volab/CNC_VoLAB/Readme.rst

++++++++++++++++++++++++++++++++++++++++++++++++++++++++++++++++++++++++++++
CNC Volab
++++++++++++++++++++++++++++++++++++++++++++++++++++++++++++++++++++++++++++

:Auteurs:              Gilles et Joël Le VoLab
:Site_Web:             http://www.vorobotics.com/
:Projet:               CNCN Volab.
:Version:              2022
:documentation:        https://volab.github.io/CNC_VoLAB/
:Licence:              CC0 4.0
:Liens:                https://creativecommons.org/licenses

Dépôt distant de notre CNC

Construite à partir d'une ancienne Charly Robot.
