volab/CNC_VoLAB/06-userDoc/documentation/materiaux.rst

++++++++++++++++++++++++++++++++++++++++++++++++++++++++++++++++++++++++++++++++++++++++++++++++++++
Matériaux
++++++++++++++++++++++++++++++++++++++++++++++++++++++++++++++++++++++++++++++++++++++++++++++++++++

:Auteur: J.Soranzo
:Date de création: 05/2022
:Date dernière maj: 05/2022
:Societe: VoRoBoTics
:Entity: VoLAB

====================================================================================================
ABS bi-couche
====================================================================================================

`GRAVIERBEDARF.de`_

.. _`GRAVIERBEDARF.de` : https://www.gravierbedarf.de/epages/63201300.sf/fr_FR/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

====================================================================================================
Weblinks
====================================================================================================

.. target-notes::
