volab/CNC_VoLAB/08-rushs/04-pictures/IMG_20201017_180309.jpg

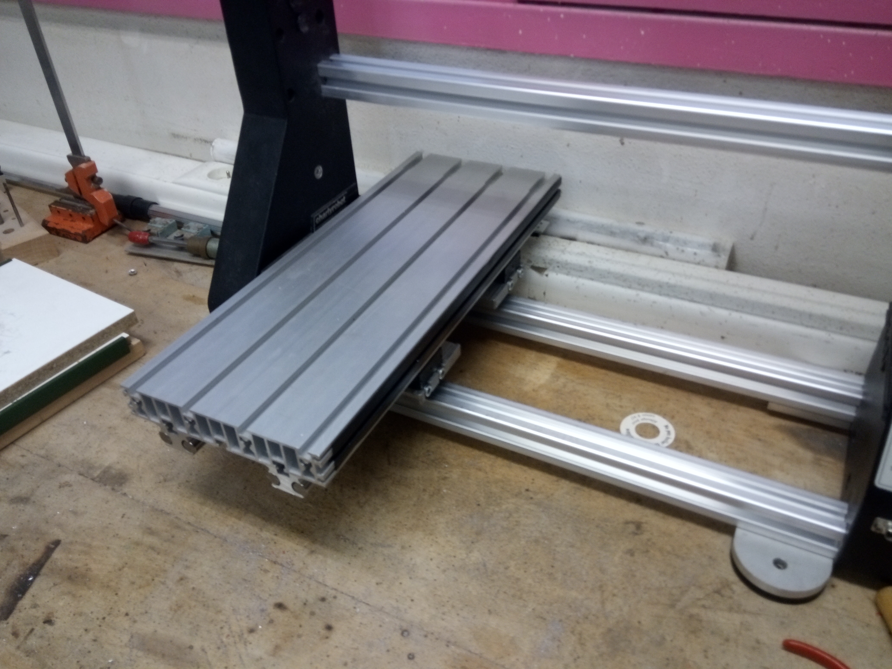
08-rushs/04-pictures/IMG_20201017_180309.jpg
