volab/CNC_VoLAB/08-rushs/04-pictures/IMG_20210306_161401.jpg

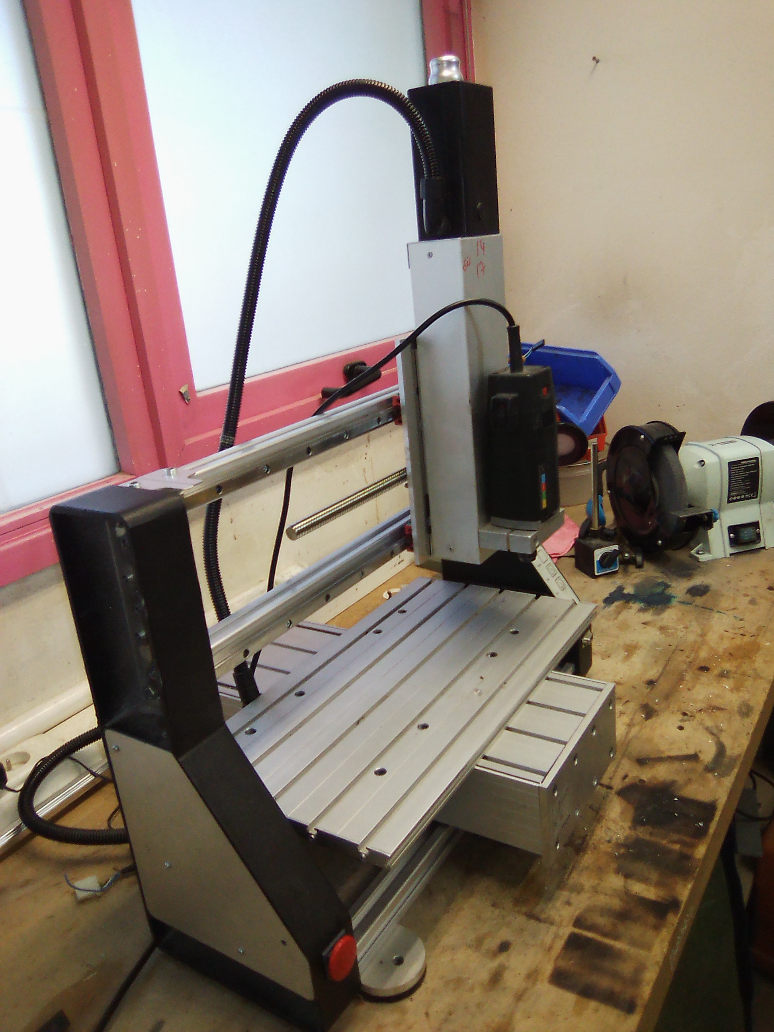
08-rushs/04-pictures/IMG_20210306_161401.jpg
