volab/CNC_VoLAB/08-rushs/04-pictures/IMG_20210313_164209.jpg

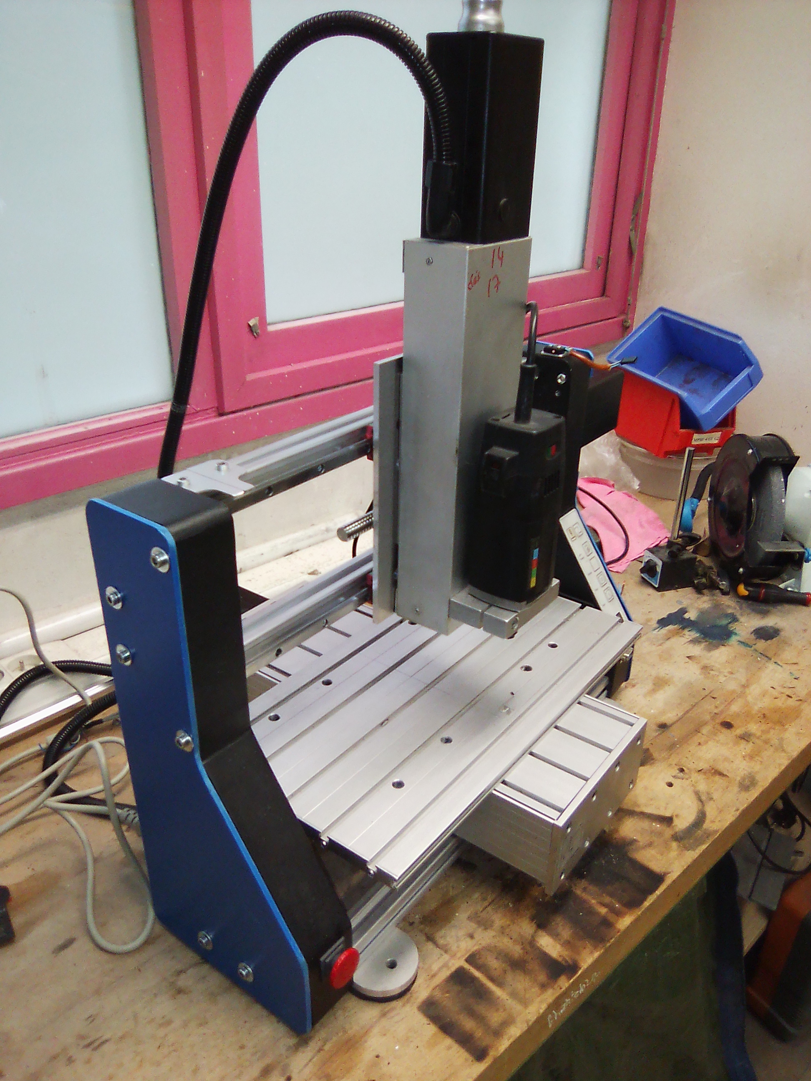
08-rushs/04-pictures/IMG_20210313_164209.jpg
