volab/CNC_VoLAB/08-rushs/04-pictures/IMG_20210320_154829.jpg

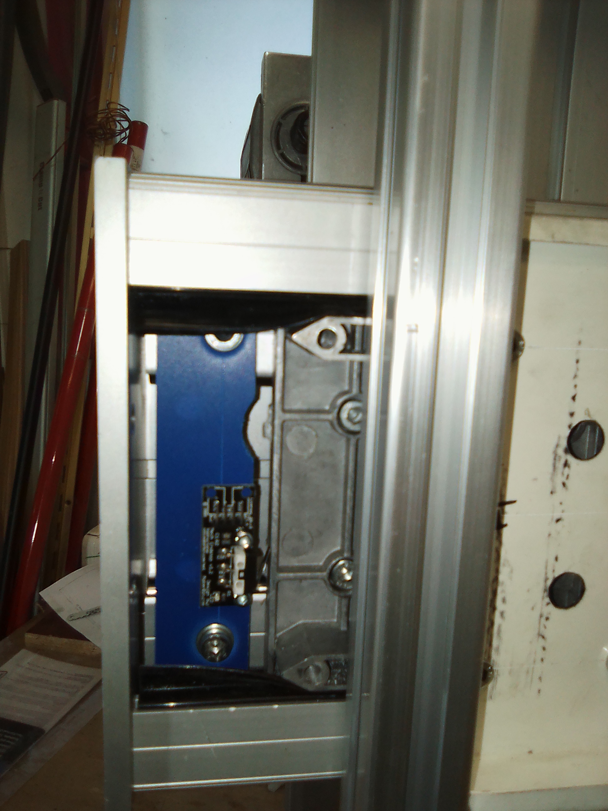
08-rushs/04-pictures/IMG_20210320_154829.jpg
