volab/CNC_VoLAB/08-rushs/04-pictures/IMG_20210320_164424.jpg

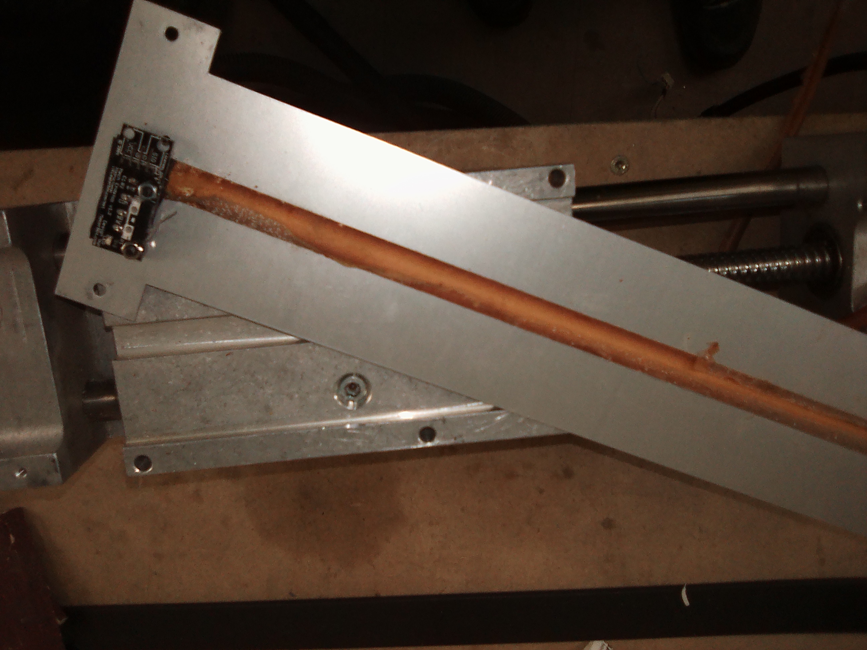
08-rushs/04-pictures/IMG_20210320_164424.jpg
