volab/CNC_VoLAB/08-rushs/04-pictures/IMG_20210424_140324.jpg

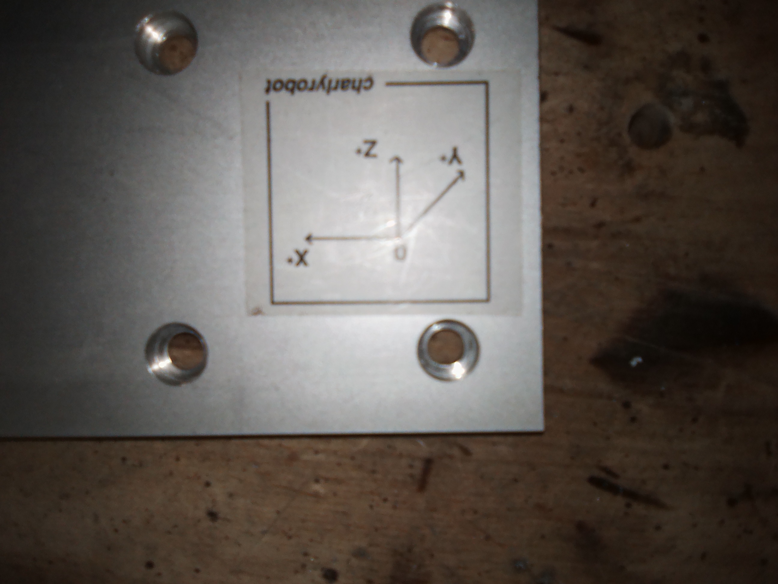
08-rushs/04-pictures/IMG_20210424_140324.jpg
