volab/CNC_VoLAB/08-rushs/04-pictures/IMG_20210501_161735.jpg

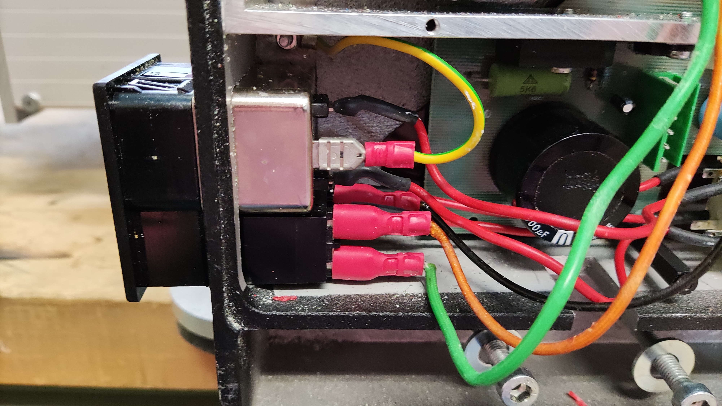
08-rushs/04-pictures/IMG_20210501_161735.jpg
