volab/CNC_VoLAB/08-rushs/04-pictures/IMG_20211218_153628.jpg

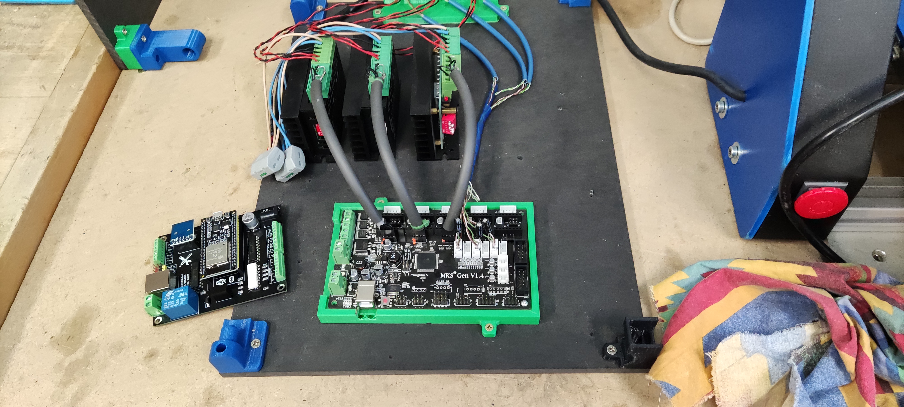
08-rushs/04-pictures/IMG_20211218_153628.jpg
