volab/CNC_VoLAB/08-rushs/04-pictures/IMG_20220129_194602.jpg

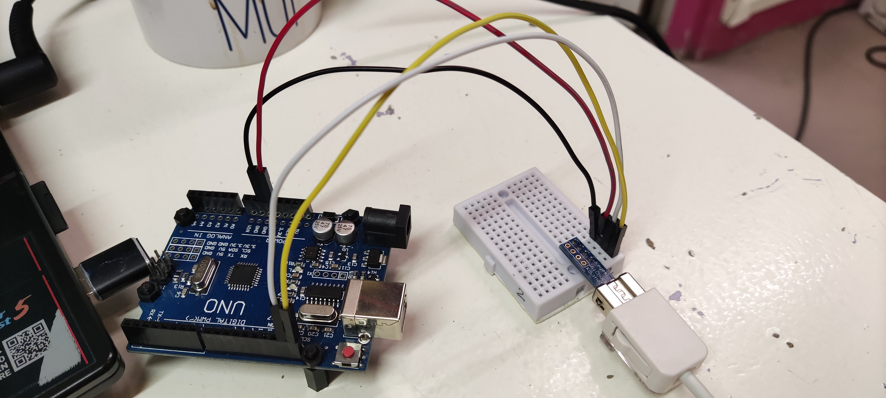
08-rushs/04-pictures/IMG_20220129_194602.jpg
