volab/CNC_VoLAB/08-rushs/04-pictures/IMG_20220527_151818.jpg

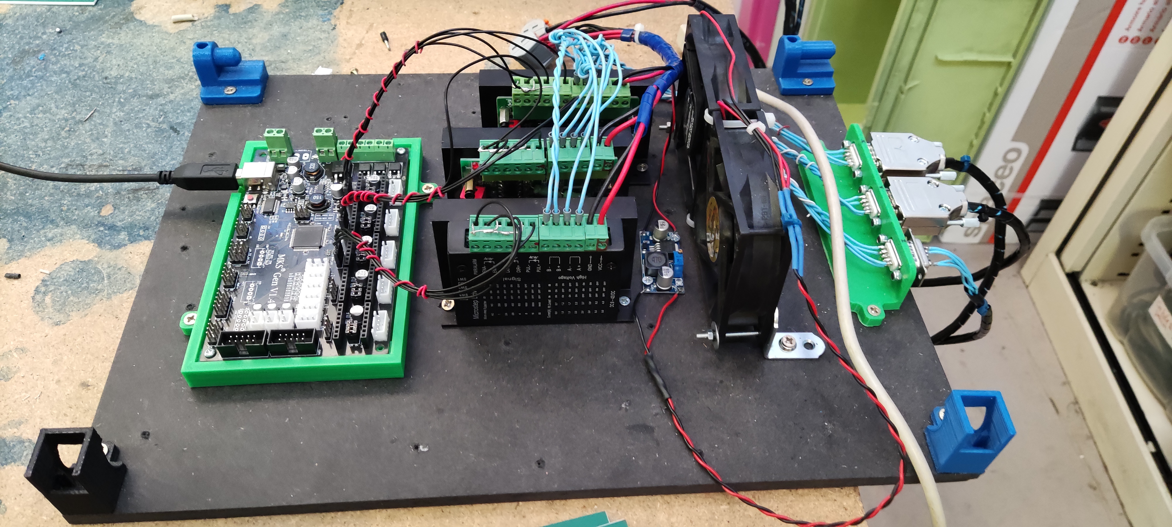
08-rushs/04-pictures/IMG_20220527_151818.jpg
