volab/CNC_VoLAB/08-rushs/04-pictures/resize/triede300.jpg

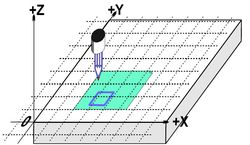
08-rushs/04-pictures/resize/triede300.jpg
