volab/CNC_VoLAB/08-rushs/04-pictures/triede.gif

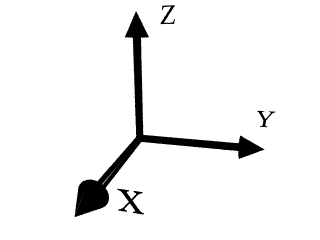
08-rushs/04-pictures/triede.gif
