volab/CNC_VoLAB/08-rushs/04-pictures/triede.jpg

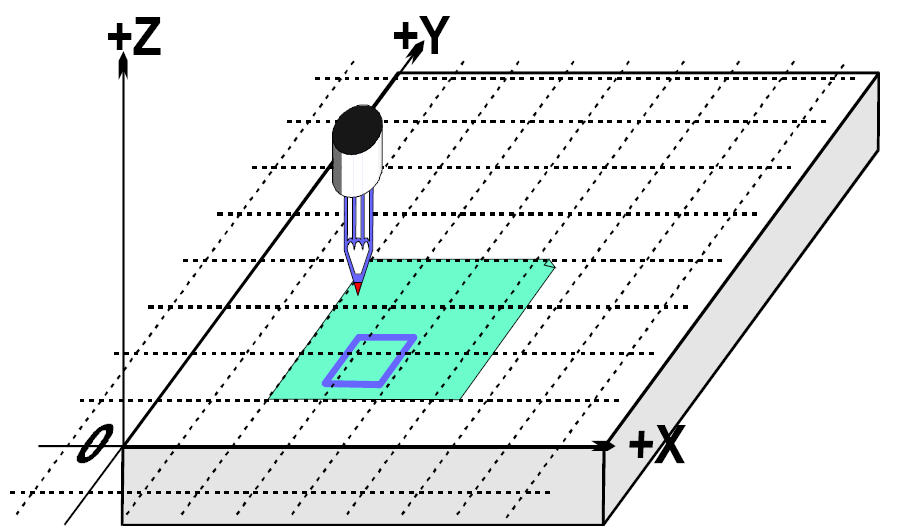
08-rushs/04-pictures/triede.jpg
