volab/CNC_VoLAB/03-conception/2020/designMeca/assemblageFreecad/CNC_VOLAB_2020_exportFromFusion360_220917_1454.FCStd

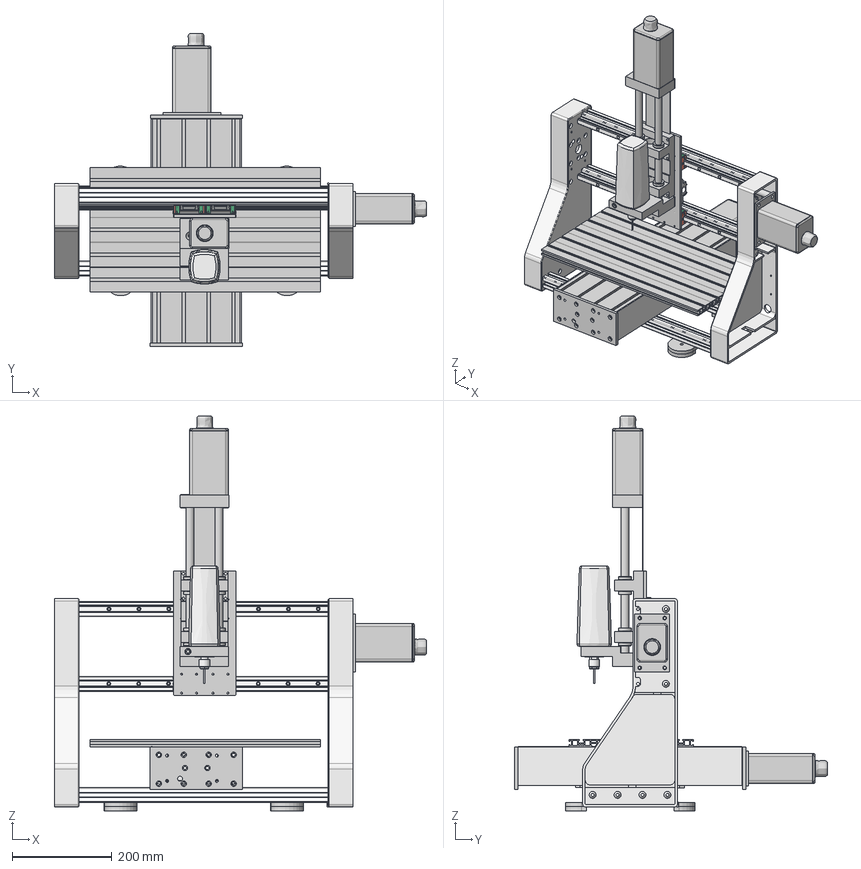
[picture p45: CAD file, 2022-11-12]
03-conception/2020/designMeca/assemblageFreecad/CNC_VOLAB_2020_exportFromFusion360_220917_1454.FCStd
747.7 x 628.2 x 793.0 mm
pied_caoutchouc v1
30X30 - T-slot - Aluminium Profile v1
pied_caoutchouc v002
pied_caoutchouc v003
30X30 - T-slot - Aluminium Profile v002
pied_caoutchouc v004
flasque_gauche v4
flasque_charioTable v1
rail_charioTable v1
rail_charioTable v002
roulement_lineaire v1
roulement_lineaire v002
Composant1
roulement_lineaire v003
roulement_lineaire v004
flasque_charioTable_moteur v1
charioTable
plaqueSupportMoteur v1
moteurMS110 v1
moteurEnveloppe v1
couvercle v1
bouton v1
plaqueTable v1
flasque_protection_chariotTable v1
flasque_protection_chariotTable v002
roulement_lineaire v005
roulement_lineaire v006
Composant002
roulement_lineaire v007
roulement_lineaire v008
Composant003
plaqueInferieureChario v1
noix_vis_bille v2
30X30 - T-slot - Aluminium Profile v003
HGR15
HGW15CC1
HGW15CC2
HGW15CC003
HGW15CC3
HGW15CC004
HGW15CC005
HGW15CC006
HGW15CC007
HGW15CC008
HGW15CC009
30X30 - T-slot - Aluminium Profile v004
HGR016
HGW15CC010
HGW15CC011
HGW15CC012
HGW15CC013
HGW15CC014
HGW15CC015
HGW15CC016
HGW15CC017
HGW15CC018
HGW15CC019
palliers v1
palliers v002
palliers v003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
